JonahSpicher/VLSI-MP4/README.md

# VLSI-MP4

Contain files for mini-project 4
