JonahSpicher/VLSI-MP4/design-files/MC_DNL.png

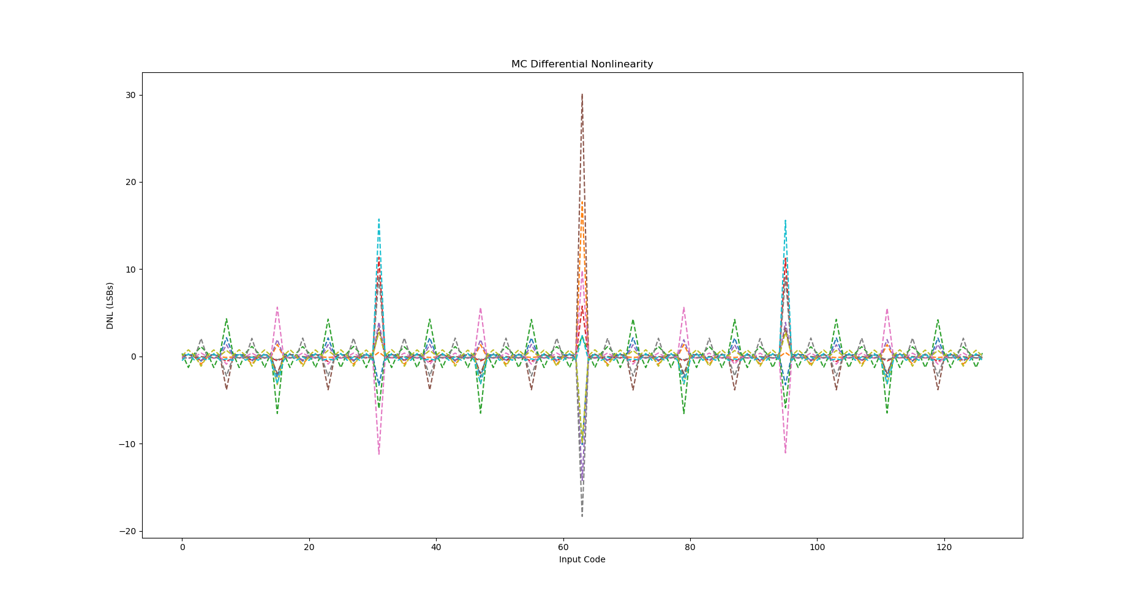
design-files/MC_DNL.png
