JonahSpicher/VLSI-MP4/design-files/MC_VTC.png

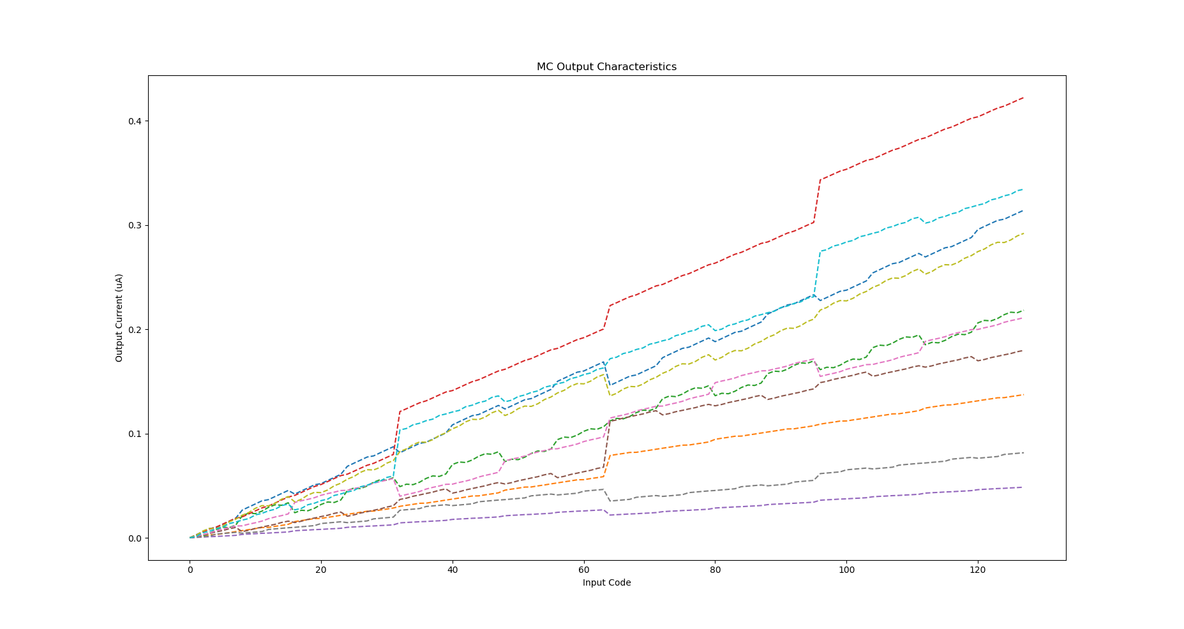
design-files/MC_VTC.png
