JonahSpicher/VLSI-MP4/design-files/single_VTC.png

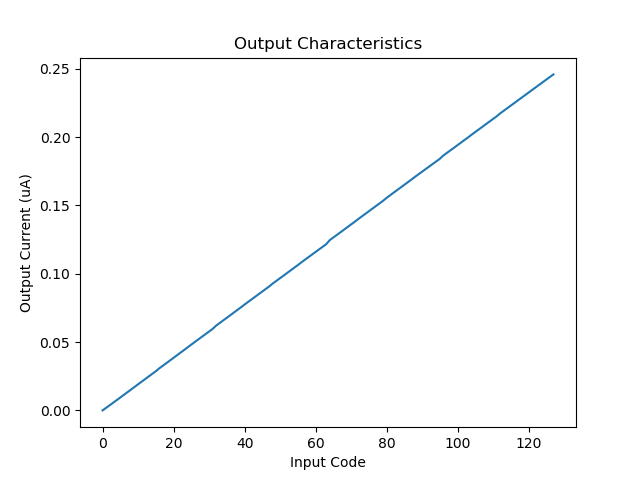
design-files/single_VTC.png
