JonahSpicher/VLSI-MP4/design-files/layout/LVS_VERIFICATION.txt

Flattening unmatched subcell biasgen in circuit dac.spice (0)(1 instance)
Flattening unmatched subcell branchl in circuit dac.spice (0)(1 instance)
Flattening unmatched subcell biasgen_opt in circuit dac_xschem.spice (1)(1 instance)
Flattening unmatched subcell branchlogic in circuit dac_xschem.spice (1)(1 instance)
Equate elements:  no current cell.
Equate elements:  no current cell.
Class dacladder:  Merged 10 devices.
Class dacladder:  Merged 10 devices.

Subcircuit summary:
Circuit 1: dacladder                       |Circuit 2: dacladder                       
-------------------------------------------|-------------------------------------------
sky130_fd_pr__nfet_01v8 (17)               |sky130_fd_pr__nfet_01v8 (17)               
Number of devices: 17                      |Number of devices: 17                      
Number of nets: 10 **Mismatch**            |Number of nets: 11 **Mismatch**            
---------------------------------------------------------------------------------------
NET mismatches: Class fragments follow (with fanout counts):
Circuit 1: dacladder                       |Circuit 2: dacladder                       

---------------------------------------------------------------------------------------
Net: VN                                    |Net: VN                                    
  sky130_fd_pr__nfet_01v8/4 = 17           |  sky130_fd_pr__nfet_01v8/2 = 4            
  sky130_fd_pr__nfet_01v8/2 = 4            |  sky130_fd_pr__nfet_01v8/(1|3) = 4        
  sky130_fd_pr__nfet_01v8/(1|3) = 4        |                                           
                                           |                                           
(no matching net)                          |Net: GND                                   
                                           |  sky130_fd_pr__nfet_01v8/4 = 17           
---------------------------------------------------------------------------------------
Netlists do not match.
  Flattening non-matched subcircuits dacladder dacladderClass dac.spice:  Merged 26 devices.
Class dac_xschem.spice:  Merged 26 devices.

Subcircuit summary:
Circuit 1: dac.spice                       |Circuit 2: dac_xschem.spice                
-------------------------------------------|-------------------------------------------
sky130_fd_pr__pfet_01v8 (25)               |sky130_fd_pr__pfet_01v8 (25)               
sky130_fd_pr__nfet_01v8 (65)               |sky130_fd_pr__nfet_01v8 (65)               
Number of devices: 90                      |Number of devices: 90                      
Number of nets: 47                         |Number of nets: 47                         
---------------------------------------------------------------------------------------
Circuits match uniquely.
Property errors were found.
Netlists match uniquely.
There were property errors.
dacladder_0/sky130_fd_pr__nfet_01v81 vs. dacladder3/sky130_fd_pr__nfet_01v8Md1:
 l circuit1: "1.4"   (unresolved expression)  (property type mismatch)
 w circuit1: "5.7"   (unresolved expression)  (property type mismatch)
dacladder_0/sky130_fd_pr__nfet_01v816 vs. dacladder3/sky130_fd_pr__nfet_01v8Md7:
 l circuit1: "1.4"   (unresolved expression)  (property type mismatch)
 w circuit1: "5.7"   (unresolved expression)  (property type mismatch)
Circuit 1 parallel/series network does not match Circuit 2
Circuit 1 instance /dacladder_0/sky130_fd_pr__nfet_01v816 network:
  l = 1.4
  w = 5.7
  ps = 0
  as = 0
  pd = 0
  ad = 0
  M = 1
Circuit 2 instance dacladder3/sky130_fd_pr__nfet_01v8Md7 network:
  m = 1
  mult = 1
  sd = 0
  sb = 0
  sa = 0
  nrs = (expression)
  nrd = (expression)
  ps = (expression)
  pd = (expression)
  as = (expression)
  ad = (expression)
  nf = 1
  W = (expression)
  L = (expression)
  m = 1
  mult = 1
  sd = 0
  sb = 0
  sa = 0
  nrs = (expression)
  nrd = (expression)
  ps = (expression)
  pd = (expression)
  as = (expression)
  ad = (expression)
  nf = 1
  W = (expression)
  L = (expression)
dacladder_0/sky130_fd_pr__nfet_01v818 vs. dacladder3/sky130_fd_pr__nfet_01v8Md11:
 l circuit1: "1.4"   (unresolved expression)  (property type mismatch)
 w circuit1: "5.7"   (unresolved expression)  (property type mismatch)
dacladder_0/sky130_fd_pr__nfet_01v820 vs. dacladder3/sky130_fd_pr__nfet_01v8Md17:
 l circuit1: "1.4"   (unresolved expression)  (property type mismatch)
 w circuit1: "5.7"   (unresolved expression)  (property type mismatch)
dacladder_0/sky130_fd_pr__nfet_01v812 vs. dacladder3/sky130_fd_pr__nfet_01v8Md20:
 l circuit1: "1.4"   (unresolved expression)  (property type mismatch)
 w circuit1: "5.7"   (unresolved expression)  (property type mismatch)
dacladder_0/sky130_fd_pr__nfet_01v810 vs. dacladder3/sky130_fd_pr__nfet_01v8Md14:
 l circuit1: "1.4"   (unresolved expression)  (property type mismatch)
 w circuit1: "5.7"   (unresolved expression)  (property type mismatch)
dacladder_0/sky130_fd_pr__nfet_01v824 vs. dacladder3/sky130_fd_pr__nfet_01v8Md23:
 l circuit1: "1.4"   (unresolved expression)  (property type mismatch)
 w circuit1: "5.7"   (unresolved expression)  (property type mismatch)
dacladder_0/sky130_fd_pr__nfet_01v85 vs. dacladder3/sky130_fd_pr__nfet_01v8Md24:
 l circuit1: "1.4"   (unresolved expression)  (property type mismatch)
 w circuit1: "5.7"   (unresolved expression)  (property type mismatch)
Circuit 1 parallel/series network does not match Circuit 2
Circuit 1 instance /dacladder_0/sky130_fd_pr__nfet_01v85 network:
  l = 1.4
  w = 5.7
  ps = 62
  as = 14.25
  pd = 49.6
  ad = 11.4
  M = 1
Circuit 2 instance dacladder3/sky130_fd_pr__nfet_01v8Md24 network:
  m = 1
  mult = 1
  sd = 0
  sb = 0
  sa = 0
  nrs = (expression)
  nrd = (expression)
  ps = (expression)
  pd = (expression)
  as = (expression)
  ad = (expression)
  nf = 1
  W = (expression)
  L = (expression)
  m = 1
  mult = 1
  sd = 0
  sb = 0
  sa = 0
  nrs = (expression)
  nrd = (expression)
  ps = (expression)
  pd = (expression)
  as = (expression)
  ad = (expression)
  nf = 1
  W = (expression)
  L = (expression)
dacladder_0/sky130_fd_pr__nfet_01v82 vs. dacladder3/sky130_fd_pr__nfet_01v8Md8:
 l circuit1: "1.4"   (unresolved expression)  (property type mismatch)
 w circuit1: "5.7"   (unresolved expression)  (property type mismatch)
Circuit 1 parallel/series network does not match Circuit 2
Circuit 1 instance /dacladder_0/sky130_fd_pr__nfet_01v82 network:
  l = 1.4
  w = 5.7
  ps = 37.2
  as = 8.55
  pd = 0
  ad = 0
  M = 1
Circuit 2 instance dacladder3/sky130_fd_pr__nfet_01v8Md8 network:
  m = 1
  mult = 1
  sd = 0
  sb = 0
  sa = 0
  nrs = (expression)
  nrd = (expression)
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
  ps = 0
  as = 0
  pd = 2.4
  ad = 0.35
  M = 1
Circuit 2 instance biasgen_opt2/sky130_fd_pr__pfet_01v8Md14 network:
  m = 1
  mult = 1
  sd = 0
  sb = 0
  sa = 0
  nrs = (expression)
  nrd = (expression)
  ps = (expression)
  pd = (expression)
  as = (expression)
  ad = (expression)
  nf = 1
  W = (expression)
  L = (expression)
  m = 1
  mult = 1
  sd = 0
  sb = 0
  sa = 0
  nrs = (expression)
  nrd = (expression)
  ps = (expression)
  pd = (expression)
  as = (expression)
  ad = (expression)
  nf = 1
  W = (expression)
  L = (expression)
Cells have no pins;  pin matching not needed.
Device classes dac.spice and dac_xschem.spice are equivalent.
Circuits match uniquely.
Property errors were found.
The following cells had property errors: dac.spice
