JonahSpicher/VLSI-MP4/design-files/opt/dac_harness_fixed_opt.spice

**.subckt dac_harness_fixed_opt
X1 VDD b0 b1 b2 b3 b4 b5 b6 GND net2 net1 dacfull
Vb0 b0 GND 1.8
Vb1 b1 GND 1.8
Vb2 b2 GND 1.8
Vb3 b3 GND 1.8
Vb4 b4 GND 1.8
Vb5 b5 GND 1.8
Vb6 b6 GND 1.8
Vdd VDD GND 1.8
R1 net1 GND 'Rbias*1000' m=1
Viout net2 net3 0
Vout net3 GND 1.8
**** begin user architecture code


.param llen=2.111177014479537
.param lwid=0.48574301322273356
.param blen=0.1693954424702104
.param bwid=1.2031310089904301
.param brlen=4.243535577472102
.param brwid=20.37706697459467
.param Rbias=4.241016659732464
.control
set wr_vecnames
set wr_singlescale
dc Vout 0 1.8 0.01
save i(Viout)
wrdata ~/VLSI/VLSI-MP4/design-files/opt/dacdata_fixed.txt i(Viout)
quit
.endc



.option wnflag=1
.param MC_SWITCH=0
.lib ~/skywater/skywater-pdk/libraries/sky130_fd_pr_ngspice/latest/models/sky130.lib.spice tt

**** end user architecture code
**.ends

* expanding   symbol:  /home/jonah/VLSI/VLSI-MP4/design-files/dacfull.sym # of pins=11
* sym_path: /home/jonah/VLSI/VLSI-MP4/design-files/dacfull.sym
* sch_path: /home/jonah/VLSI/VLSI-MP4/design-files/dacfull.sch
.subckt dacfull  VP b0 b1 b2 b3 b4 b5 b6 VN Iout Rbias
*.iopin VP
*.iopin VN
*.iopin Rbias
*.iopin Iout
*.ipin b0
*.ipin b1
*.ipin b2
*.ipin b3
*.ipin b4
*.ipin b5
*.ipin b6
X3 net7 net6 net5 net4 net3 net2 VP VN Iout net1 dacladder
X2 Rbias net9 net8 VP VN biasgen_opt
X1 VP net9 net8 VN net7 b0 b1 b2 b3 b4 b5 b6 net6 net5 net4 net3 net2 net1 branchlogic
.ends


* expanding   symbol:  /home/jonah/VLSI/VLSI-MP4/design-files/dacladder.sym # of pins=10
* sym_path: /home/jonah/VLSI/VLSI-MP4/design-files/dacladder.sym
* sch_path: /home/jonah/VLSI/VLSI-MP4/design-files/dacladder.sch
.subckt dacladder  branch0 branch1 branch2 branch3 branch4 branch5 VP VN Iout branch6
*.iopin branch0
*.iopin branch1
*.iopin branch2
*.iopin branch3
*.iopin branch4
*.iopin branch5
*.iopin branch6
*.iopin Iout
*.iopin VN
*.iopin VP
XMd1 VP VN VN GND sky130_fd_pr__nfet_01v8 L='llen' W='lwid' nf=1 ad='int((nf+1)/2) * W/nf * 0.29' as='int((nf+2)/2) * W/nf * 0.29'
+ pd='2*int((nf+1)/2) * (W/nf + 0.29)' ps='2*int((nf+2)/2) * (W/nf + 0.29)' nrd='0.29 / W' nrs='0.29 / W'
+ sa=0 sb=0 sd=0 mult=1 m=1
XMd7 branch0 VP VP GND sky130_fd_pr__nfet_01v8 L='llen' W='lwid' nf=1 ad='int((nf+1)/2) * W/nf * 0.29'
+ as='int((nf+2)/2) * W/nf * 0.29' pd='2*int((nf+1)/2) * (W/nf + 0.29)' ps='2*int((nf+2)/2) * (W/nf + 0.29)'
+ nrd='0.29 / W' nrs='0.29 / W' sa=0 sb=0 sd=0 mult=1 m=1
XMd8 branch1 VP branch0 GND sky130_fd_pr__nfet_01v8 L='llen' W='lwid' nf=1 ad='int((nf+1)/2) * W/nf * 0.29'
+ as='int((nf+2)/2) * W/nf * 0.29' pd='2*int((nf+1)/2) * (W/nf + 0.29)' ps='2*int((nf+2)/2) * (W/nf + 0.29)'
+ nrd='0.29 / W' nrs='0.29 / W' sa=0 sb=0 sd=0 mult=1 m=1
XMd2 branch0 VN VN GND sky130_fd_pr__nfet_01v8 L='llen' W='lwid' nf=1 ad='int((nf+1)/2) * W/nf * 0.29'
+ as='int((nf+2)/2) * W/nf * 0.29' pd='2*int((nf+1)/2) * (W/nf + 0.29)' ps='2*int((nf+2)/2) * (W/nf + 0.29)'
+ nrd='0.29 / W' nrs='0.29 / W' sa=0 sb=0 sd=0 mult=1 m=1
XMd9 VP VP branch0 GND sky130_fd_pr__nfet_01v8 L='llen' W='lwid' nf=1 ad='int((nf+1)/2) * W/nf * 0.29'
+ as='int((nf+2)/2) * W/nf * 0.29' pd='2*int((nf+1)/2) * (W/nf + 0.29)' ps='2*int((nf+2)/2) * (W/nf + 0.29)'
+ nrd='0.29 / W' nrs='0.29 / W' sa=0 sb=0 sd=0 mult=1 m=1
XMd3 branch0 VN VN GND sky130_fd_pr__nfet_01v8 L='llen' W='lwid' nf=1 ad='int((nf+1)/2) * W/nf * 0.29'
+ as='int((nf+2)/2) * W/nf * 0.29' pd='2*int((nf+1)/2) * (W/nf + 0.29)' ps='2*int((nf+2)/2) * (W/nf + 0.29)'
+ nrd='0.29 / W' nrs='0.29 / W' sa=0 sb=0 sd=0 mult=1 m=1
XMd10 branch1 VP branch0 GND sky130_fd_pr__nfet_01v8 L='llen' W='lwid' nf=1 ad='int((nf+1)/2) * W/nf * 0.29'
+ as='int((nf+2)/2) * W/nf * 0.29' pd='2*int((nf+1)/2) * (W/nf + 0.29)' ps='2*int((nf+2)/2) * (W/nf + 0.29)'
+ nrd='0.29 / W' nrs='0.29 / W' sa=0 sb=0 sd=0 mult=1 m=1
XMd11 VP VP branch1 GND sky130_fd_pr__nfet_01v8 L='llen' W='lwid' nf=1 ad='int((nf+1)/2) * W/nf * 0.29'
+ as='int((nf+2)/2) * W/nf * 0.29' pd='2*int((nf+1)/2) * (W/nf + 0.29)' ps='2*int((nf+2)/2) * (W/nf + 0.29)'
+ nrd='0.29 / W' nrs='0.29 / W' sa=0 sb=0 sd=0 mult=1 m=1
XMd12 branch2 VP branch1 GND sky130_fd_pr__nfet_01v8 L='llen' W='lwid' nf=1 ad='int((nf+1)/2) * W/nf * 0.29'
+ as='int((nf+2)/2) * W/nf * 0.29' pd='2*int((nf+1)/2) * (W/nf + 0.29)' ps='2*int((nf+2)/2) * (W/nf + 0.29)'
+ nrd='0.29 / W' nrs='0.29 / W' sa=0 sb=0 sd=0 mult=1 m=1
XMd13 branch2 VP branch1 GND sky130_fd_pr__nfet_01v8 L='llen' W='lwid' nf=1 ad='int((nf+1)/2) * W/nf * 0.29'
+ as='int((nf+2)/2) * W/nf * 0.29' pd='2*int((nf+1)/2) * (W/nf + 0.29)' ps='2*int((nf+2)/2) * (W/nf + 0.29)'
+ nrd='0.29 / W' nrs='0.29 / W' sa=0 sb=0 sd=0 mult=1 m=1
XMd14 VP VP branch2 GND sky130_fd_pr__nfet_01v8 L='llen' W='lwid' nf=1 ad='int((nf+1)/2) * W/nf * 0.29'
+ as='int((nf+2)/2) * W/nf * 0.29' pd='2*int((nf+1)/2) * (W/nf + 0.29)' ps='2*int((nf+2)/2) * (W/nf + 0.29)'
+ nrd='0.29 / W' nrs='0.29 / W' sa=0 sb=0 sd=0 mult=1 m=1
XMd15 branch3 VP branch2 GND sky130_fd_pr__nfet_01v8 L='llen' W='lwid' nf=1 ad='int((nf+1)/2) * W/nf * 0.29'
+ as='int((nf+2)/2) * W/nf * 0.29' pd='2*int((nf+1)/2) * (W/nf + 0.29)' ps='2*int((nf+2)/2) * (W/nf + 0.29)'
+ nrd='0.29 / W' nrs='0.29 / W' sa=0 sb=0 sd=0 mult=1 m=1
XMd16 branch3 VP branch2 GND sky130_fd_pr__nfet_01v8 L='llen' W='lwid' nf=1 ad='int((nf+1)/2) * W/nf * 0.29'
+ as='int((nf+2)/2) * W/nf * 0.29' pd='2*int((nf+1)/2) * (W/nf + 0.29)' ps='2*int((nf+2)/2) * (W/nf + 0.29)'
+ nrd='0.29 / W' nrs='0.29 / W' sa=0 sb=0 sd=0 mult=1 m=1
XMd17 VP VP branch3 GND sky130_fd_pr__nfet_01v8 L='llen' W='lwid' nf=1 ad='int((nf+1)/2) * W/nf * 0.29'
+ as='int((nf+2)/2) * W/nf * 0.29' pd='2*int((nf+1)/2) * (W/nf + 0.29)' ps='2*int((nf+2)/2) * (W/nf + 0.29)'
+ nrd='0.29 / W' nrs='0.29 / W' sa=0 sb=0 sd=0 mult=1 m=1
XMd18 branch4 VP branch3 GND sky130_fd_pr__nfet_01v8 L='llen' W='lwid' nf=1 ad='int((nf+1)/2) * W/nf * 0.29'
+ as='int((nf+2)/2) * W/nf * 0.29' pd='2*int((nf+1)/2) * (W/nf + 0.29)' ps='2*int((nf+2)/2) * (W/nf + 0.29)'
+ nrd='0.29 / W' nrs='0.29 / W' sa=0 sb=0 sd=0 mult=1 m=1
XMd19 branch4 VP branch3 GND sky130_fd_pr__nfet_01v8 L='llen' W='lwid' nf=1 ad='int((nf+1)/2) * W/nf * 0.29'
+ as='int((nf+2)/2) * W/nf * 0.29' pd='2*int((nf+1)/2) * (W/nf + 0.29)' ps='2*int((nf+2)/2) * (W/nf + 0.29)'
+ nrd='0.29 / W' nrs='0.29 / W' sa=0 sb=0 sd=0 mult=1 m=1
XMd20 VP VP branch4 GND sky130_fd_pr__nfet_01v8 L='llen' W='lwid' nf=1 ad='int((nf+1)/2) * W/nf * 0.29'
+ as='int((nf+2)/2) * W/nf * 0.29' pd='2*int((nf+1)/2) * (W/nf + 0.29)' ps='2*int((nf+2)/2) * (W/nf + 0.29)'
+ nrd='0.29 / W' nrs='0.29 / W' sa=0 sb=0 sd=0 mult=1 m=1
XMd21 branch5 VP branch4 GND sky130_fd_pr__nfet_01v8 L='llen' W='lwid' nf=1 ad='int((nf+1)/2) * W/nf * 0.29'
+ as='int((nf+2)/2) * W/nf * 0.29' pd='2*int((nf+1)/2) * (W/nf + 0.29)' ps='2*int((nf+2)/2) * (W/nf + 0.29)'
+ nrd='0.29 / W' nrs='0.29 / W' sa=0 sb=0 sd=0 mult=1 m=1
XMd22 branch5 VP branch4 GND sky130_fd_pr__nfet_01v8 L='llen' W='lwid' nf=1 ad='int((nf+1)/2) * W/nf * 0.29'
+ as='int((nf+2)/2) * W/nf * 0.29' pd='2*int((nf+1)/2) * (W/nf + 0.29)' ps='2*int((nf+2)/2) * (W/nf + 0.29)'
+ nrd='0.29 / W' nrs='0.29 / W' sa=0 sb=0 sd=0 mult=1 m=1
XMd23 VP VP branch5 GND sky130_fd_pr__nfet_01v8 L='llen' W='lwid' nf=1 ad='int((nf+1)/2) * W/nf * 0.29'
+ as='int((nf+2)/2) * W/nf * 0.29' pd='2*int((nf+1)/2) * (W/nf + 0.29)' ps='2*int((nf+2)/2) * (W/nf + 0.29)'
+ nrd='0.29 / W' nrs='0.29 / W' sa=0 sb=0 sd=0 mult=1 m=1
XMd24 branch6 VP branch5 GND sky130_fd_pr__nfet_01v8 L='llen' W='lwid' nf=1 ad='int((nf+1)/2) * W/nf * 0.29'
+ as='int((nf+2)/2) * W/nf * 0.29' pd='2*int((nf+1)/2) * (W/nf + 0.29)' ps='2*int((nf+2)/2) * (W/nf + 0.29)'
+ nrd='0.29 / W' nrs='0.29 / W' sa=0 sb=0 sd=0 mult=1 m=1
XMd25 branch6 VP branch5 GND sky130_fd_pr__nfet_01v8 L='llen' W='lwid' nf=1 ad='int((nf+1)/2) * W/nf * 0.29'
+ as='int((nf+2)/2) * W/nf * 0.29' pd='2*int((nf+1)/2) * (W/nf + 0.29)' ps='2*int((nf+2)/2) * (W/nf + 0.29)'
+ nrd='0.29 / W' nrs='0.29 / W' sa=0 sb=0 sd=0 mult=1 m=1
XMd4 VN VN branch6 GND sky130_fd_pr__nfet_01v8 L='llen' W='lwid' nf=1 ad='int((nf+1)/2) * W/nf * 0.29'
+ as='int((nf+2)/2) * W/nf * 0.29' pd='2*int((nf+1)/2) * (W/nf + 0.29)' ps='2*int((nf+2)/2) * (W/nf + 0.29)'
+ nrd='0.29 / W' nrs='0.29 / W' sa=0 sb=0 sd=0 mult=1 m=1
XMd5 Iout VP branch6 GND sky130_fd_pr__nfet_01v8 L='llen' W='lwid' nf=1 ad='int((nf+1)/2) * W/nf * 0.29'
+ as='int((nf+2)/2) * W/nf * 0.29' pd='2*int((nf+1)/2) * (W/nf + 0.29)' ps='2*int((nf+2)/2) * (W/nf + 0.29)'
+ nrd='0.29 / W' nrs='0.29 / W' sa=0 sb=0 sd=0 mult=1 m=1
XMd26 VN VN Iout GND sky130_fd_pr__nfet_01v8 L='llen' W='lwid' nf=1 ad='int((nf+1)/2) * W/nf * 0.29'
+ as='int((nf+2)/2) * W/nf * 0.29' pd='2*int((nf+1)/2) * (W/nf + 0.29)' ps='2*int((nf+2)/2) * (W/nf + 0.29)'
+ nrd='0.29 / W' nrs='0.29 / W' sa=0 sb=0 sd=0 mult=1 m=1
XMd6 Iout VP branch6 GND sky130_fd_pr__nfet_01v8 L='llen' W='lwid' nf=1 ad='int((nf+1)/2) * W/nf * 0.29'
+ as='int((nf+2)/2) * W/nf * 0.29' pd='2*int((nf+1)/2) * (W/nf + 0.29)' ps='2*int((nf+2)/2) * (W/nf + 0.29)'
+ nrd='0.29 / W' nrs='0.29 / W' sa=0 sb=0 sd=0 mult=1 m=1
XMd27 VN VN Iout GND sky130_fd_pr__nfet_01v8 L='llen' W='lwid' nf=1 ad='int((nf+1)/2) * W/nf * 0.29'
+ as='int((nf+2)/2) * W/nf * 0.29' pd='2*int((nf+1)/2) * (W/nf + 0.29)' ps='2*int((nf+2)/2) * (W/nf + 0.29)'
+ nrd='0.29 / W' nrs='0.29 / W' sa=0 sb=0 sd=0 mult=1 m=1
.ends


* expanding   symbol:  /home/jonah/VLSI/VLSI-MP4/design-files/opt/biasgen_opt.sym # of pins=5
* sym_path: /home/jonah/VLSI/VLSI-MP4/design-files/opt/biasgen_opt.sym
* sch_path: /home/jonah/VLSI/VLSI-MP4/design-files/opt/biasgen_opt.sch
.subckt biasgen_opt  Rbias Vbn Vc VP VN
*.iopin Rbias
*.iopin Vbn
*.iopin Vc
*.iopin VP
*.iopin VN
XMd1 VP VP net2 VDD sky130_fd_pr__pfet_01v8 L='blen' W='bwid/2' nf=1 ad='int((nf+1)/2) * W/nf * 0.29'
+ as='int((nf+2)/2) * W/nf * 0.29' pd='2*int((nf+1)/2) * (W/nf + 0.29)' ps='2*int((nf+2)/2) * (W/nf + 0.29)'
+ nrd='0.29 / W' nrs='0.29 / W' sa=0 sb=0 sd=0 mult=1 m=1
XMd6 net1 VN VN GND sky130_fd_pr__nfet_01v8 L='blen' W='bwid/2' nf=1 ad='int((nf+1)/2) * W/nf * 0.29'
+ as='int((nf+2)/2) * W/nf * 0.29' pd='2*int((nf+1)/2) * (W/nf + 0.29)' ps='2*int((nf+2)/2) * (W/nf + 0.29)'
+ nrd='0.29 / W' nrs='0.29 / W' sa=0 sb=0 sd=0 mult=1 m=1
XMd2 net2 net1 VP VDD sky130_fd_pr__pfet_01v8 L='blen' W='bwid/2' nf=1 ad='int((nf+1)/2) * W/nf * 0.29'
+ as='int((nf+2)/2) * W/nf * 0.29' pd='2*int((nf+1)/2) * (W/nf + 0.29)' ps='2*int((nf+2)/2) * (W/nf + 0.29)'
+ nrd='0.29 / W' nrs='0.29 / W' sa=0 sb=0 sd=0 mult=1 m=1
XMd20 VP net1 Vbn VDD sky130_fd_pr__pfet_01v8 L='blen' W='bwid/2' nf=1 ad='int((nf+1)/2) * W/nf * 0.29'
+ as='int((nf+2)/2) * W/nf * 0.29' pd='2*int((nf+1)/2) * (W/nf + 0.29)' ps='2*int((nf+2)/2) * (W/nf + 0.29)'
+ nrd='0.29 / W' nrs='0.29 / W' sa=0 sb=0 sd=0 mult=1 m=1
XMd21 Vbn net1 VP VDD sky130_fd_pr__pfet_01v8 L='blen' W='bwid/2' nf=1 ad='int((nf+1)/2) * W/nf * 0.29'
+ as='int((nf+2)/2) * W/nf * 0.29' pd='2*int((nf+1)/2) * (W/nf + 0.29)' ps='2*int((nf+2)/2) * (W/nf + 0.29)'
+ nrd='0.29 / W' nrs='0.29 / W' sa=0 sb=0 sd=0 mult=1 m=1
XMd23 VP net1 net2 VDD sky130_fd_pr__pfet_01v8 L='blen' W='bwid/2' nf=1 ad='int((nf+1)/2) * W/nf * 0.29'
+ as='int((nf+2)/2) * W/nf * 0.29' pd='2*int((nf+1)/2) * (W/nf + 0.29)' ps='2*int((nf+2)/2) * (W/nf + 0.29)'
+ nrd='0.29 / W' nrs='0.29 / W' sa=0 sb=0 sd=0 mult=1 m=1
XMd24 net2 VP VP VDD sky130_fd_pr__pfet_01v8 L='blen' W='bwid/2' nf=1 ad='int((nf+1)/2) * W/nf * 0.29'
+ as='int((nf+2)/2) * W/nf * 0.29' pd='2*int((nf+1)/2) * (W/nf + 0.29)' ps='2*int((nf+2)/2) * (W/nf + 0.29)'
+ nrd='0.29 / W' nrs='0.29 / W' sa=0 sb=0 sd=0 mult=1 m=1
XMd3 VP VP net3 VDD sky130_fd_pr__pfet_01v8 L='blen' W='bwid/2' nf=1 ad='int((nf+1)/2) * W/nf * 0.29'
+ as='int((nf+2)/2) * W/nf * 0.29' pd='2*int((nf+1)/2) * (W/nf + 0.29)' ps='2*int((nf+2)/2) * (W/nf + 0.29)'
+ nrd='0.29 / W' nrs='0.29 / W' sa=0 sb=0 sd=0 mult=1 m=1
XMd8 net3 net3 VP VDD sky130_fd_pr__pfet_01v8 L='blen' W='bwid/2' nf=1 ad='int((nf+1)/2) * W/nf * 0.29'
+ as='int((nf+2)/2) * W/nf * 0.29' pd='2*int((nf+1)/2) * (W/nf + 0.29)' ps='2*int((nf+2)/2) * (W/nf + 0.29)'
+ nrd='0.29 / W' nrs='0.29 / W' sa=0 sb=0 sd=0 mult=1 m=1
XMd25 VP net3 net1 VDD sky130_fd_pr__pfet_01v8 L='blen' W='bwid/2' nf=1 ad='int((nf+1)/2) * W/nf * 0.29'
+ as='int((nf+2)/2) * W/nf * 0.29' pd='2*int((nf+1)/2) * (W/nf + 0.29)' ps='2*int((nf+2)/2) * (W/nf + 0.29)'
+ nrd='0.29 / W' nrs='0.29 / W' sa=0 sb=0 sd=0 mult=1 m=1
XMd26 net1 net3 VP VDD sky130_fd_pr__pfet_01v8 L='blen' W='bwid/2' nf=1 ad='int((nf+1)/2) * W/nf * 0.29'
+ as='int((nf+2)/2) * W/nf * 0.29' pd='2*int((nf+1)/2) * (W/nf + 0.29)' ps='2*int((nf+2)/2) * (W/nf + 0.29)'
+ nrd='0.29 / W' nrs='0.29 / W' sa=0 sb=0 sd=0 mult=1 m=1
XMd27 VP net3 net3 VDD sky130_fd_pr__pfet_01v8 L='blen' W='bwid/2' nf=1 ad='int((nf+1)/2) * W/nf * 0.29'
+ as='int((nf+2)/2) * W/nf * 0.29' pd='2*int((nf+1)/2) * (W/nf + 0.29)' ps='2*int((nf+2)/2) * (W/nf + 0.29)'
+ nrd='0.29 / W' nrs='0.29 / W' sa=0 sb=0 sd=0 mult=1 m=1
XMd28 net3 VP VP VDD sky130_fd_pr__pfet_01v8 L='blen' W='bwid/2' nf=1 ad='int((nf+1)/2) * W/nf * 0.29'
+ as='int((nf+2)/2) * W/nf * 0.29' pd='2*int((nf+1)/2) * (W/nf + 0.29)' ps='2*int((nf+2)/2) * (W/nf + 0.29)'
+ nrd='0.29 / W' nrs='0.29 / W' sa=0 sb=0 sd=0 mult=1 m=1
XMd10 VP VP net5 VDD sky130_fd_pr__pfet_01v8 L='blen' W='bwid/2' nf=1 ad='int((nf+1)/2) * W/nf * 0.29'
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
XMd50 VN VN net2 GND sky130_fd_pr__nfet_01v8 L='blen' W='bwid*4' nf=1 ad='int((nf+1)/2) * W/nf * 0.29'
+ as='int((nf+2)/2) * W/nf * 0.29' pd='2*int((nf+1)/2) * (W/nf + 0.29)' ps='2*int((nf+2)/2) * (W/nf + 0.29)'
+ nrd='0.29 / W' nrs='0.29 / W' sa=0 sb=0 sd=0 mult=1 m=1
.ends
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
