JonahSpicher/VLSI-MP4/design-files/opt/dac_harness_opt.spice

**.subckt dac_harness_opt
Vb0 b0 GND 1.8
Vb1 b1 GND 1.8
Vb2 b2 GND 1.8
Vb3 b3 GND 1.8
Vb4 b4 GND 1.8
Vb5 b5 GND 1.8
Vb6 b6 GND 1.8
Vdd VDD GND 1.8
R1 net1 GND 'Rbias*1000' m=1
Viout net2 net3 0
Vout net3 GND 1.8
X1 VDD b0 b1 b2 b3 b4 b5 b6 GND net2 net1 dacfull_opt
**** begin user architecture code


.param llen=2.1131000232493578
.param lwid=0.487997437158356
.param blen=0.16925751599224573
.param bwid=1.2007978416938037
.param brlen=4.263435242697646
.param brwid=20.199572298759293
.param Rbias=4.248192260389352
.control
	set wr_vecnames
	set wr_singlescale
	let code = 0
	while code < 128
		if code eq 0
			let nb0 = 0
		else
			let nb0 = (code % 2)*1.8
		end
		if floor(code / 2) eq 0
			let nb1 = 0
		else
			let nb1 = (floor(code / 2) % 2)*1.8
		end
		if floor(code / 4) eq 0
			let nb2 = 0
		else
			let nb2 = (floor(code / 4) % 2)*1.8
		end
		if floor(code / 8) eq 0
			let nb3 = 0
		else
			let nb3 = (floor(code / 8) % 2)*1.8
		end
		if floor(code / 16) eq 0
			let nb4 = 0
		else
			let nb4 = (floor(code / 16) % 2)*1.8
		end
		if floor(code / 32) eq 0
			let nb5 = 0
		else
			let nb5 = (floor(code / 32) % 2)*1.8
		end
		if floor(code / 64) eq 0
			let nb6 = 0
		else
			let nb6 = (floor(code / 64) % 2)*1.8
		end
		alter Vb0 $&nb0
		alter Vb1 $&nb1
		alter Vb2 $&nb2
		alter Vb3 $&nb3
		alter Vb4 $&nb4
		alter Vb5 $&nb5
		alter Vb6 $&nb6
		save i(Viout) v(b0) v(b1) v(b2) v(b3) v(b4) v(b5) v(b6)
		op
		wrdata ~/VLSI/VLSI-MP4/design-files/opt/dacdata.txt i(Viout)
		if code eq 0
			set appendwrite
			set wr_vecnames = FALSE
		end
		let code = code + 1
	end
	quit
.endc


.option wnflag=1
.param MC_SWITCH=0
.lib ~/skywater/skywater-pdk/libraries/sky130_fd_pr_ngspice/latest/models/sky130.lib.spice tt

**** end user architecture code
**.ends

* expanding   symbol:  /home/jonah/VLSI/VLSI-MP4/design-files/opt/dacfull_opt.sym # of pins=11
* sym_path: /home/jonah/VLSI/VLSI-MP4/design-files/opt/dacfull_opt.sym
* sch_path: /home/jonah/VLSI/VLSI-MP4/design-files/opt/dacfull_opt.sch
.subckt dacfull_opt  VP b0 b1 b2 b3 b4 b5 b6 VN Iout Rbias
*.iopin VP
*.iopin VN
*.iopin Rbias
*.iopin Iout
*.ipin b0
*.ipin b1
*.ipin b2
*.ipin b3
*.ipin b4
*.ipin b5
*.ipin b6
X1 Rbias net9 net8 VP VN biasgen_opt
X3 net7 net6 net5 net4 net3 net2 VP VN Iout net1 dacladder_opt
X2 VP net9 net8 VN net7 b0 b1 b2 b3 b4 b5 b6 net6 net5 net4 net3 net2 net1 branchlogic
.ends


* expanding   symbol:  /home/jonah/VLSI/VLSI-MP4/design-files/opt/biasgen_opt.sym # of pins=5
* sym_path: /home/jonah/VLSI/VLSI-MP4/design-files/opt/biasgen_opt.sym
* sch_path: /home/jonah/VLSI/VLSI-MP4/design-files/opt/biasgen_opt.sch
.subckt biasgen_opt  Rbias Vbn Vc VP VN
*.iopin Rbias
*.iopin Vbn
*.iopin Vc
*.iopin VP
*.iopin VN
XMd1 VP VP net2 VDD sky130_fd_pr__pfet_01v8 L='blen' W='bwid/2' nf=1 ad='int((nf+1)/2) * W/nf * 0.29'
+ as='int((nf+2)/2) * W/nf * 0.29' pd='2*int((nf+1)/2) * (W/nf + 0.29)' ps='2*int((nf+2)/2) * (W/nf + 0.29)'
+ nrd='0.29 / W' nrs='0.29 / W' sa=0 sb=0 sd=0 mult=1 m=1
XMd6 net1 VN VN GND sky130_fd_pr__nfet_01v8 L='blen' W='bwid/2' nf=1 ad='int((nf+1)/2) * W/nf * 0.29'
+ as='int((nf+2)/2) * W/nf * 0.29' pd='2*int((nf+1)/2) * (W/nf + 0.29)' ps='2*int((nf+2)/2) * (W/nf + 0.29)'
+ nrd='0.29 / W' nrs='0.29 / W' sa=0 sb=0 sd=0 mult=1 m=1
XMd2 net2 net1 VP VDD sky130_fd_pr__pfet_01v8 L='blen' W='bwid/2' nf=1 ad='int((nf+1)/2) * W/nf * 0.29'
+ as='int((nf+2)/2) * W/nf * 0.29' pd='2*int((nf+1)/2) * (W/nf + 0.29)' ps='2*int((nf+2)/2) * (W/nf + 0.29)'
+ nrd='0.29 / W' nrs='0.29 / W' sa=0 sb=0 sd=0 mult=1 m=1
XMd20 VP net1 Vbn VDD sky130_fd_pr__pfet_01v8 L='blen' W='bwid/2' nf=1 ad='int((nf+1)/2) * W/nf * 0.29'
+ as='int((nf+2)/2) * W/nf * 0.29' pd='2*int((nf+1)/2) * (W/nf + 0.29)' ps='2*int((nf+2)/2) * (W/nf + 0.29)'
+ nrd='0.29 / W' nrs='0.29 / W' sa=0 sb=0 sd=0 mult=1 m=1
XMd21 Vbn net1 VP VDD sky130_fd_pr__pfet_01v8 L='blen' W='bwid/2' nf=1 ad='int((nf+1)/2) * W/nf * 0.29'
+ as='int((nf+2)/2) * W/nf * 0.29' pd='2*int((nf+1)/2) * (W/nf + 0.29)' ps='2*int((nf+2)/2) * (W/nf + 0.29)'
+ nrd='0.29 / W' nrs='0.29 / W' sa=0 sb=0 sd=0 mult=1 m=1
XMd23 VP net1 net2 VDD sky130_fd_pr__pfet_01v8 L='blen' W='bwid/2' nf=1 ad='int((nf+1)/2) * W/nf * 0.29'
+ as='int((nf+2)/2) * W/nf * 0.29' pd='2*int((nf+1)/2) * (W/nf + 0.29)' ps='2*int((nf+2)/2) * (W/nf + 0.29)'
+ nrd='0.29 / W' nrs='0.29 / W' sa=0 sb=0 sd=0 mult=1 m=1
XMd24 net2 VP VP VDD sky130_fd_pr__pfet_01v8 L='blen' W='bwid/2' nf=1 ad='int((nf+1)/2) * W/nf * 0.29'
+ as='int((nf+2)/2) * W/nf * 0.29' pd='2*int((nf+1)/2) * (W/nf + 0.29)' ps='2*int((nf+2)/2) * (W/nf + 0.29)'
+ nrd='0.29 / W' nrs='0.29 / W' sa=0 sb=0 sd=0 mult=1 m=1
XMd3 VP VP net3 VDD sky130_fd_pr__pfet_01v8 L='blen' W='bwid/2' nf=1 ad='int((nf+1)/2) * W/nf * 0.29'
+ as='int((nf+2)/2) * W/nf * 0.29' pd='2*int((nf+1)/2) * (W/nf + 0.29)' ps='2*int((nf+2)/2) * (W/nf + 0.29)'
+ nrd='0.29 / W' nrs='0.29 / W' sa=0 sb=0 sd=0 mult=1 m=1
XMd8 net3 net3 VP VDD sky130_fd_pr__pfet_01v8 L='blen' W='bwid/2' nf=1 ad='int((nf+1)/2) * W/nf * 0.29'
+ as='int((nf+2)/2) * W/nf * 0.29' pd='2*int((nf+1)/2) * (W/nf + 0.29)' ps='2*int((nf+2)/2) * (W/nf + 0.29)'
+ nrd='0.29 / W' nrs='0.29 / W' sa=0 sb=0 sd=0 mult=1 m=1
XMd25 VP net3 net1 VDD sky130_fd_pr__pfet_01v8 L='blen' W='bwid/2' nf=1 ad='int((nf+1)/2) * W/nf * 0.29'
+ as='int((nf+2)/2) * W/nf * 0.29' pd='2*int((nf+1)/2) * (W/nf + 0.29)' ps='2*int((nf+2)/2) * (W/nf + 0.29)'
+ nrd='0.29 / W' nrs='0.29 / W' sa=0 sb=0 sd=0 mult=1 m=1
XMd26 net1 net3 VP VDD sky130_fd_pr__pfet_01v8 L='blen' W='bwid/2' nf=1 ad='int((nf+1)/2) * W/nf * 0.29'
+ as='int((nf+2)/2) * W/nf * 0.29' pd='2*int((nf+1)/2) * (W/nf + 0.29)' ps='2*int((nf+2)/2) * (W/nf + 0.29)'
+ nrd='0.29 / W' nrs='0.29 / W' sa=0 sb=0 sd=0 mult=1 m=1
XMd27 VP net3 net3 VDD sky130_fd_pr__pfet_01v8 L='blen' W='bwid/2' nf=1 ad='int((nf+1)/2) * W/nf * 0.29'
+ as='int((nf+2)/2) * W/nf * 0.29' pd='2*int((nf+1)/2) * (W/nf + 0.29)' ps='2*int((nf+2)/2) * (W/nf + 0.29)'
+ nrd='0.29 / W' nrs='0.29 / W' sa=0 sb=0 sd=0 mult=1 m=1
XMd28 net3 VP VP VDD sky130_fd_pr__pfet_01v8 L='blen' W='bwid/2' nf=1 ad='int((nf+1)/2) * W/nf * 0.29'
+ as='int((nf+2)/2) * W/nf * 0.29' pd='2*int((nf+1)/2) * (W/nf + 0.29)' ps='2*int((nf+2)/2) * (W/nf + 0.29)'
+ nrd='0.29 / W' nrs='0.29 / W' sa=0 sb=0 sd=0 mult=1 m=1
XMd10 VP VP net5 VDD sky130_fd_pr__pfet_01v8 L='blen' W='bwid/2' nf=1 ad='int((nf+1)/2) * W/nf * 0.29'
+ as='int((nf+2)/2) * W/nf * 0.29' pd='2*int((nf+1)/2) * (W/nf + 0.29)' ps='2*int((nf+2)/2) * (W/nf + 0.29)'
+ nrd='0.29 / W' nrs='0.29 / W' sa=0 sb=0 sd=0 mult=1 m=1
XMd29 net5 net5 VP VDD sky130_fd_pr__pfet_01v8 L='blen' W='bwid/2' nf=1 ad='int((nf+1)/2) * W/nf * 0.29'
+ as='int((nf+2)/2) * W/nf * 0.29' pd='2*int((nf+1)/2) * (W/nf + 0.29)' ps='2*int((nf+2)/2) * (W/nf + 0.29)'
+ nrd='0.29 / W' nrs='0.29 / W' sa=0 sb=0 sd=0 mult=1 m=1
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
+ nrd='0.29 / W' nrs='0.29 / W' sa=0 sb=0 sd=0 mult=1 m=1
XMd18 Vc Vc net6 GND sky130_fd_pr__nfet_01v8 L='blen' W='bwid/2' nf=1 ad='int((nf+1)/2) * W/nf * 0.29'
+ as='int((nf+2)/2) * W/nf * 0.29' pd='2*int((nf+1)/2) * (W/nf + 0.29)' ps='2*int((nf+2)/2) * (W/nf + 0.29)'
+ nrd='0.29 / W' nrs='0.29 / W' sa=0 sb=0 sd=0 mult=1 m=1
XMd46 net6 Vc Vc GND sky130_fd_pr__nfet_01v8 L='blen' W='bwid/2' nf=1 ad='int((nf+1)/2) * W/nf * 0.29'
+ as='int((nf+2)/2) * W/nf * 0.29' pd='2*int((nf+1)/2) * (W/nf + 0.29)' ps='2*int((nf+2)/2) * (W/nf + 0.29)'
+ nrd='0.29 / W' nrs='0.29 / W' sa=0 sb=0 sd=0 mult=1 m=1
XMd47 net4 net4 net6 GND sky130_fd_pr__nfet_01v8 L='blen' W='bwid/2' nf=1 ad='int((nf+1)/2) * W/nf * 0.29'
+ as='int((nf+2)/2) * W/nf * 0.29' pd='2*int((nf+1)/2) * (W/nf + 0.29)' ps='2*int((nf+2)/2) * (W/nf + 0.29)'
+ nrd='0.29 / W' nrs='0.29 / W' sa=0 sb=0 sd=0 mult=1 m=1
XMd48 VN VN net4 GND sky130_fd_pr__nfet_01v8 L='blen' W='bwid/2' nf=1 ad='int((nf+1)/2) * W/nf * 0.29'
+ as='int((nf+2)/2) * W/nf * 0.29' pd='2*int((nf+1)/2) * (W/nf + 0.29)' ps='2*int((nf+2)/2) * (W/nf + 0.29)'
+ nrd='0.29 / W' nrs='0.29 / W' sa=0 sb=0 sd=0 mult=1 m=1
XMd4 net2 VN VN GND sky130_fd_pr__nfet_01v8 L='blen' W='bwid*4' nf=1 ad='int((nf+1)/2) * W/nf * 0.29'
+ as='int((nf+2)/2) * W/nf * 0.29' pd='2*int((nf+1)/2) * (W/nf + 0.29)' ps='2*int((nf+2)/2) * (W/nf + 0.29)'
+ nrd='0.29 / W' nrs='0.29 / W' sa=0 sb=0 sd=0 mult=1 m=1
XMd5 Rbias net2 net2 GND sky130_fd_pr__nfet_01v8 L='blen' W='bwid*4' nf=1 ad='int((nf+1)/2) * W/nf * 0.29'
+ as='int((nf+2)/2) * W/nf * 0.29' pd='2*int((nf+1)/2) * (W/nf + 0.29)' ps='2*int((nf+2)/2) * (W/nf + 0.29)'
+ nrd='0.29 / W' nrs='0.29 / W' sa=0 sb=0 sd=0 mult=1 m=1
XMd49 net2 net2 Rbias GND sky130_fd_pr__nfet_01v8 L='blen' W='bwid*4' nf=1 ad='int((nf+1)/2) * W/nf * 0.29'
+ as='int((nf+2)/2) * W/nf * 0.29' pd='2*int((nf+1)/2) * (W/nf + 0.29)' ps='2*int((nf+2)/2) * (W/nf + 0.29)'
+ nrd='0.29 / W' nrs='0.29 / W' sa=0 sb=0 sd=0 mult=1 m=1
XMd50 VN VN net2 GND sky130_fd_pr__nfet_01v8 L='blen' W='bwid*4' nf=1 ad='int((nf+1)/2) * W/nf * 0.29'
+ as='int((nf+2)/2) * W/nf * 0.29' pd='2*int((nf+1)/2) * (W/nf + 0.29)' ps='2*int((nf+2)/2) * (W/nf + 0.29)'
+ nrd='0.29 / W' nrs='0.29 / W' sa=0 sb=0 sd=0 mult=1 m=1
.ends


* expanding   symbol:  /home/jonah/VLSI/VLSI-MP4/design-files/opt/dacladder_opt.sym # of pins=10
* sym_path: /home/jonah/VLSI/VLSI-MP4/design-files/opt/dacladder_opt.sym
* sch_path: /home/jonah/VLSI/VLSI-MP4/design-files/opt/dacladder_opt.sch
.subckt dacladder_opt  branch0 branch1 branch2 branch3 branch4 branch5 VP VN Iout branch6
*.iopin branch0
*.iopin branch1
*.iopin branch2
*.iopin branch3
*.iopin branch4
*.iopin branch5
*.iopin branch6
*.iopin Iout
*.iopin VN
*.iopin VP
XMd1 VP VN VN GND sky130_fd_pr__nfet_01v8 L='llen' W='lwid' nf=1 ad='int((nf+1)/2) * W/nf * 0.29' as='int((nf+2)/2) * W/nf * 0.29'
+ pd='2*int((nf+1)/2) * (W/nf + 0.29)' ps='2*int((nf+2)/2) * (W/nf + 0.29)' nrd='0.29 / W' nrs='0.29 / W'
+ sa=0 sb=0 sd=0 mult=1 m=1
XMd7 branch0 VP VP GND sky130_fd_pr__nfet_01v8 L='llen' W='lwid' nf=1 ad='int((nf+1)/2) * W/nf * 0.29'
+ as='int((nf+2)/2) * W/nf * 0.29' pd='2*int((nf+1)/2) * (W/nf + 0.29)' ps='2*int((nf+2)/2) * (W/nf + 0.29)'
+ nrd='0.29 / W' nrs='0.29 / W' sa=0 sb=0 sd=0 mult=1 m=1
XMd8 branch1 VP branch0 GND sky130_fd_pr__nfet_01v8 L='llen' W='lwid' nf=1 ad='int((nf+1)/2) * W/nf * 0.29'
+ as='int((nf+2)/2) * W/nf * 0.29' pd='2*int((nf+1)/2) * (W/nf + 0.29)' ps='2*int((nf+2)/2) * (W/nf + 0.29)'
+ nrd='0.29 / W' nrs='0.29 / W' sa=0 sb=0 sd=0 mult=1 m=1
XMd2 branch0 VN VN GND sky130_fd_pr__nfet_01v8 L='llen' W='lwid' nf=1 ad='int((nf+1)/2) * W/nf * 0.29'
+ as='int((nf+2)/2) * W/nf * 0.29' pd='2*int((nf+1)/2) * (W/nf + 0.29)' ps='2*int((nf+2)/2) * (W/nf + 0.29)'
+ nrd='0.29 / W' nrs='0.29 / W' sa=0 sb=0 sd=0 mult=1 m=1
XMd9 VP VP branch0 GND sky130_fd_pr__nfet_01v8 L='llen' W='lwid' nf=1 ad='int((nf+1)/2) * W/nf * 0.29'
+ as='int((nf+2)/2) * W/nf * 0.29' pd='2*int((nf+1)/2) * (W/nf + 0.29)' ps='2*int((nf+2)/2) * (W/nf + 0.29)'
+ nrd='0.29 / W' nrs='0.29 / W' sa=0 sb=0 sd=0 mult=1 m=1
XMd3 branch0 VN VN GND sky130_fd_pr__nfet_01v8 L='llen' W='lwid' nf=1 ad='int((nf+1)/2) * W/nf * 0.29'
+ as='int((nf+2)/2) * W/nf * 0.29' pd='2*int((nf+1)/2) * (W/nf + 0.29)' ps='2*int((nf+2)/2) * (W/nf + 0.29)'
+ nrd='0.29 / W' nrs='0.29 / W' sa=0 sb=0 sd=0 mult=1 m=1
XMd10 branch1 VP branch0 GND sky130_fd_pr__nfet_01v8 L='llen' W='lwid' nf=1 ad='int((nf+1)/2) * W/nf * 0.29'
+ as='int((nf+2)/2) * W/nf * 0.29' pd='2*int((nf+1)/2) * (W/nf + 0.29)' ps='2*int((nf+2)/2) * (W/nf + 0.29)'
+ nrd='0.29 / W' nrs='0.29 / W' sa=0 sb=0 sd=0 mult=1 m=1
XMd11 VP VP branch1 GND sky130_fd_pr__nfet_01v8 L='llen' W='lwid' nf=1 ad='int((nf+1)/2) * W/nf * 0.29'
+ as='int((nf+2)/2) * W/nf * 0.29' pd='2*int((nf+1)/2) * (W/nf + 0.29)' ps='2*int((nf+2)/2) * (W/nf + 0.29)'
+ nrd='0.29 / W' nrs='0.29 / W' sa=0 sb=0 sd=0 mult=1 m=1
XMd12 branch2 VP branch1 GND sky130_fd_pr__nfet_01v8 L='llen' W='lwid' nf=1 ad='int((nf+1)/2) * W/nf * 0.29'
+ as='int((nf+2)/2) * W/nf * 0.29' pd='2*int((nf+1)/2) * (W/nf + 0.29)' ps='2*int((nf+2)/2) * (W/nf + 0.29)'
+ nrd='0.29 / W' nrs='0.29 / W' sa=0 sb=0 sd=0 mult=1 m=1
XMd13 branch2 VP branch1 GND sky130_fd_pr__nfet_01v8 L='llen' W='lwid' nf=1 ad='int((nf+1)/2) * W/nf * 0.29'
+ as='int((nf+2)/2) * W/nf * 0.29' pd='2*int((nf+1)/2) * (W/nf + 0.29)' ps='2*int((nf+2)/2) * (W/nf + 0.29)'
+ nrd='0.29 / W' nrs='0.29 / W' sa=0 sb=0 sd=0 mult=1 m=1
XMd14 VP VP branch2 GND sky130_fd_pr__nfet_01v8 L='llen' W='lwid' nf=1 ad='int((nf+1)/2) * W/nf * 0.29'
+ as='int((nf+2)/2) * W/nf * 0.29' pd='2*int((nf+1)/2) * (W/nf + 0.29)' ps='2*int((nf+2)/2) * (W/nf + 0.29)'
+ nrd='0.29 / W' nrs='0.29 / W' sa=0 sb=0 sd=0 mult=1 m=1
XMd15 branch3 VP branch2 GND sky130_fd_pr__nfet_01v8 L='llen' W='lwid' nf=1 ad='int((nf+1)/2) * W/nf * 0.29'
+ as='int((nf+2)/2) * W/nf * 0.29' pd='2*int((nf+1)/2) * (W/nf + 0.29)' ps='2*int((nf+2)/2) * (W/nf + 0.29)'
+ nrd='0.29 / W' nrs='0.29 / W' sa=0 sb=0 sd=0 mult=1 m=1
XMd16 branch3 VP branch2 GND sky130_fd_pr__nfet_01v8 L='llen' W='lwid' nf=1 ad='int((nf+1)/2) * W/nf * 0.29'
+ as='int((nf+2)/2) * W/nf * 0.29' pd='2*int((nf+1)/2) * (W/nf + 0.29)' ps='2*int((nf+2)/2) * (W/nf + 0.29)'
+ nrd='0.29 / W' nrs='0.29 / W' sa=0 sb=0 sd=0 mult=1 m=1
XMd17 VP VP branch3 GND sky130_fd_pr__nfet_01v8 L='llen' W='lwid' nf=1 ad='int((nf+1)/2) * W/nf * 0.29'
+ as='int((nf+2)/2) * W/nf * 0.29' pd='2*int((nf+1)/2) * (W/nf + 0.29)' ps='2*int((nf+2)/2) * (W/nf + 0.29)'
+ nrd='0.29 / W' nrs='0.29 / W' sa=0 sb=0 sd=0 mult=1 m=1
XMd18 branch4 VP branch3 GND sky130_fd_pr__nfet_01v8 L='llen' W='lwid' nf=1 ad='int((nf+1)/2) * W/nf * 0.29'
+ as='int((nf+2)/2) * W/nf * 0.29' pd='2*int((nf+1)/2) * (W/nf + 0.29)' ps='2*int((nf+2)/2) * (W/nf + 0.29)'
+ nrd='0.29 / W' nrs='0.29 / W' sa=0 sb=0 sd=0 mult=1 m=1
XMd19 branch4 VP branch3 GND sky130_fd_pr__nfet_01v8 L='llen' W='lwid' nf=1 ad='int((nf+1)/2) * W/nf * 0.29'
+ as='int((nf+2)/2) * W/nf * 0.29' pd='2*int((nf+1)/2) * (W/nf + 0.29)' ps='2*int((nf+2)/2) * (W/nf + 0.29)'
+ nrd='0.29 / W' nrs='0.29 / W' sa=0 sb=0 sd=0 mult=1 m=1
XMd20 VP VP branch4 GND sky130_fd_pr__nfet_01v8 L='llen' W='lwid' nf=1 ad='int((nf+1)/2) * W/nf * 0.29'
+ as='int((nf+2)/2) * W/nf * 0.29' pd='2*int((nf+1)/2) * (W/nf + 0.29)' ps='2*int((nf+2)/2) * (W/nf + 0.29)'
+ nrd='0.29 / W' nrs='0.29 / W' sa=0 sb=0 sd=0 mult=1 m=1
XMd21 branch5 VP branch4 GND sky130_fd_pr__nfet_01v8 L='llen' W='lwid' nf=1 ad='int((nf+1)/2) * W/nf * 0.29'
+ as='int((nf+2)/2) * W/nf * 0.29' pd='2*int((nf+1)/2) * (W/nf + 0.29)' ps='2*int((nf+2)/2) * (W/nf + 0.29)'
+ nrd='0.29 / W' nrs='0.29 / W' sa=0 sb=0 sd=0 mult=1 m=1
XMd22 branch5 VP branch4 GND sky130_fd_pr__nfet_01v8 L='llen' W='lwid' nf=1 ad='int((nf+1)/2) * W/nf * 0.29'
+ as='int((nf+2)/2) * W/nf * 0.29' pd='2*int((nf+1)/2) * (W/nf + 0.29)' ps='2*int((nf+2)/2) * (W/nf + 0.29)'
+ nrd='0.29 / W' nrs='0.29 / W' sa=0 sb=0 sd=0 mult=1 m=1
XMd23 VP VP branch5 GND sky130_fd_pr__nfet_01v8 L='llen' W='lwid' nf=1 ad='int((nf+1)/2) * W/nf * 0.29'
+ as='int((nf+2)/2) * W/nf * 0.29' pd='2*int((nf+1)/2) * (W/nf + 0.29)' ps='2*int((nf+2)/2) * (W/nf + 0.29)'
+ nrd='0.29 / W' nrs='0.29 / W' sa=0 sb=0 sd=0 mult=1 m=1
XMd24 branch6 VP branch5 GND sky130_fd_pr__nfet_01v8 L='llen' W='lwid' nf=1 ad='int((nf+1)/2) * W/nf * 0.29'
+ as='int((nf+2)/2) * W/nf * 0.29' pd='2*int((nf+1)/2) * (W/nf + 0.29)' ps='2*int((nf+2)/2) * (W/nf + 0.29)'
+ nrd='0.29 / W' nrs='0.29 / W' sa=0 sb=0 sd=0 mult=1 m=1
XMd25 branch6 VP branch5 GND sky130_fd_pr__nfet_01v8 L='llen' W='lwid' nf=1 ad='int((nf+1)/2) * W/nf * 0.29'
+ as='int((nf+2)/2) * W/nf * 0.29' pd='2*int((nf+1)/2) * (W/nf + 0.29)' ps='2*int((nf+2)/2) * (W/nf + 0.29)'
+ nrd='0.29 / W' nrs='0.29 / W' sa=0 sb=0 sd=0 mult=1 m=1
XMd4 VN VN branch6 GND sky130_fd_pr__nfet_01v8 L='llen' W='lwid' nf=1 ad='int((nf+1)/2) * W/nf * 0.29'
+ as='int((nf+2)/2) * W/nf * 0.29' pd='2*int((nf+1)/2) * (W/nf + 0.29)' ps='2*int((nf+2)/2) * (W/nf + 0.29)'
+ nrd='0.29 / W' nrs='0.29 / W' sa=0 sb=0 sd=0 mult=1 m=1
XMd5 Iout VP branch6 GND sky130_fd_pr__nfet_01v8 L='llen' W='lwid' nf=1 ad='int((nf+1)/2) * W/nf * 0.29'
+ as='int((nf+2)/2) * W/nf * 0.29' pd='2*int((nf+1)/2) * (W/nf + 0.29)' ps='2*int((nf+2)/2) * (W/nf + 0.29)'
+ nrd='0.29 / W' nrs='0.29 / W' sa=0 sb=0 sd=0 mult=1 m=1
XMd26 VN VN Iout GND sky130_fd_pr__nfet_01v8 L='llen' W='lwid' nf=1 ad='int((nf+1)/2) * W/nf * 0.29'
+ as='int((nf+2)/2) * W/nf * 0.29' pd='2*int((nf+1)/2) * (W/nf + 0.29)' ps='2*int((nf+2)/2) * (W/nf + 0.29)'
+ nrd='0.29 / W' nrs='0.29 / W' sa=0 sb=0 sd=0 mult=1 m=1
XMd6 Iout VP branch6 GND sky130_fd_pr__nfet_01v8 L='llen' W='lwid' nf=1 ad='int((nf+1)/2) * W/nf * 0.29'
+ as='int((nf+2)/2) * W/nf * 0.29' pd='2*int((nf+1)/2) * (W/nf + 0.29)' ps='2*int((nf+2)/2) * (W/nf + 0.29)'
+ nrd='0.29 / W' nrs='0.29 / W' sa=0 sb=0 sd=0 mult=1 m=1
XMd27 VN VN Iout GND sky130_fd_pr__nfet_01v8 L='llen' W='lwid' nf=1 ad='int((nf+1)/2) * W/nf * 0.29'
+ as='int((nf+2)/2) * W/nf * 0.29' pd='2*int((nf+1)/2) * (W/nf + 0.29)' ps='2*int((nf+2)/2) * (W/nf + 0.29)'
+ nrd='0.29 / W' nrs='0.29 / W' sa=0 sb=0 sd=0 mult=1 m=1
.ends
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
