JonahSpicher/VLSI-MP4/(commit log)

2021-04-03 Uploaded files so far
    [biasgen.sch, branchlogic.sch, dacladder.sch, inv.sch, testing.sch, vbcalc.sch]
2021-04-04 Updated designs, added optimizer code
    [biasgen.sch, dacdata.csv, testing.sch]
2021-04-07 Started layout, dacladder and branchlogic done
    [biasgen.sch, branchlogic.sch, dac_harness.sch, dacfull.sch, dacladder.sch, untitled.sch]
2021-04-14 Finished layout for original design
    [biasgen_old.sch, biasgen_opt.sch, branchlogic.sch, dac_harness_MC.sch, dac_harness_MC_opt.sch, dac_harness_fixed_opt.sch, dac_harness_opt.sch, dac_harness_varied_output.sch]
2021-05-11 Added all final changes
    [biasgen-m2.sch, branchlogic-m2.sch, dac_harness-m2.sch, dacfull-m2.sch, dacladder-m2.sch]
